jakkra/Agilent-6626A-GUI/PCB/cad_models/CT3151SP-6.igs

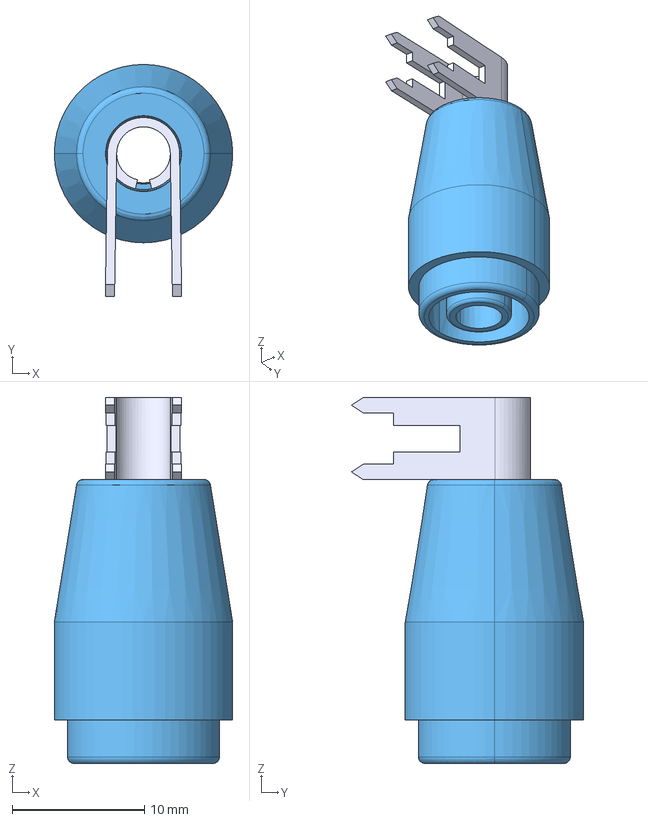
[picture p7: CAD file, 2024-12-04]
PCB/cad_models/CT3151SP-6.igs
13.5 x 17.6 x 27.7 mm
