jakkra/Agilent-6626A-GUI/PCB/cad_models/Same_Sky_UJ2-AH-4-TH.step

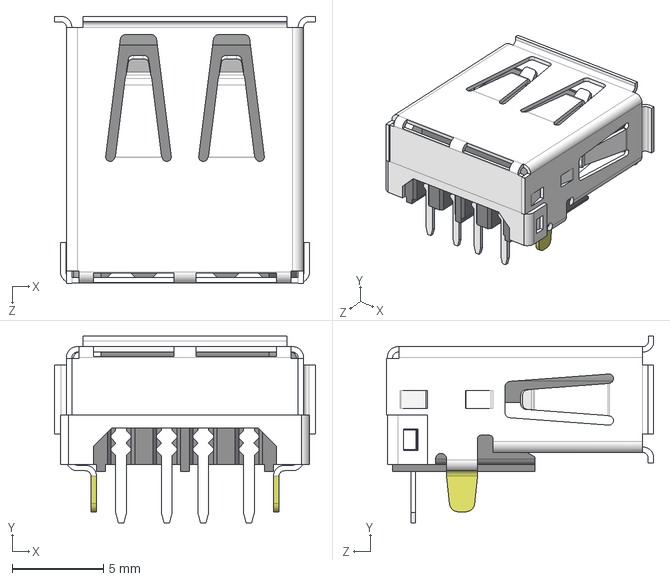
[picture p8: CAD file, 2024-12-04]
PCB/cad_models/Same_Sky_UJ2-AH-4-TH.step
14.3 x 10.2 x 14.7 mm
