jakkra/Agilent-6626A-GUI/PCB/cad_models/EG1213.stp

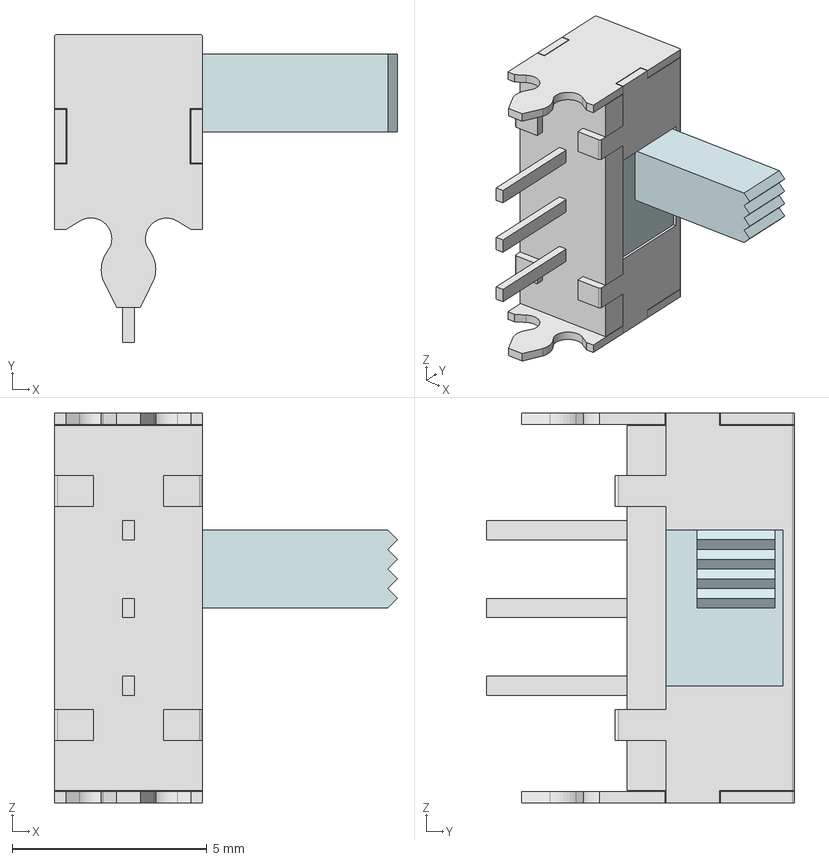
[picture p9: CAD file, 2024-12-04]
PCB/cad_models/EG1213.stp
8.80 x 7.90 x 10.0 mm
EG1213 SHELL
EG1213 TERM
EG1213 ACTUATOR
