jakkra/Agilent-6626A-GUI/PCB/cad_models/SOT-5X3-8.stp

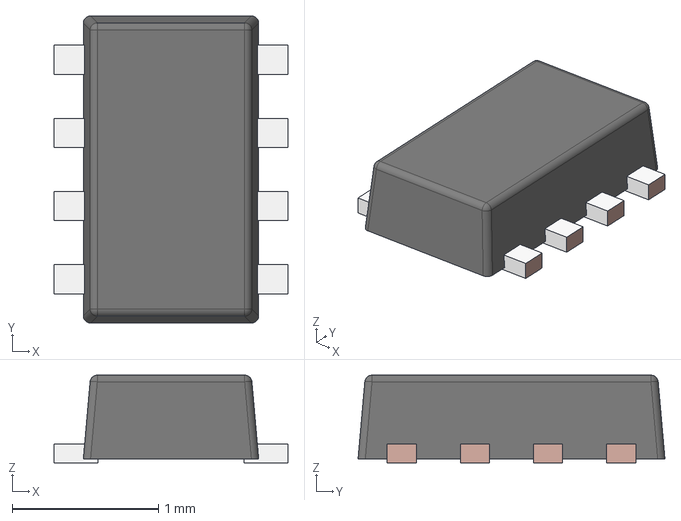
[picture p10: CAD file, 2024-12-04]
PCB/cad_models/SOT-5X3-8.stp
1.60 x 2.10 x 0.6 mm
FRAME-DRL0008A
BODY-SOT
