jakkra/Agilent-6626A-GUI/PCB/cad_models/SOT-323-5.stp

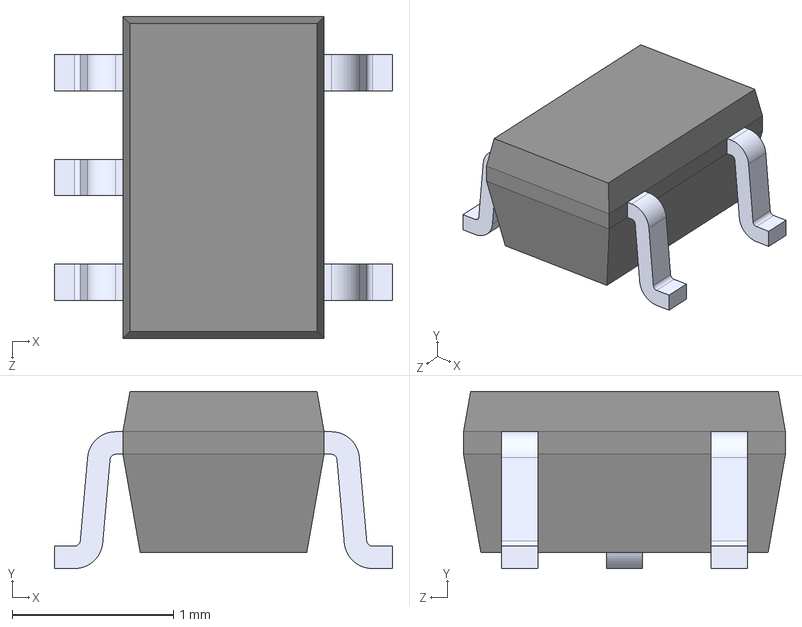
[picture p11: CAD file, 2024-12-04]
PCB/cad_models/SOT-323-5.stp
2.10 x 1.10 x 2.00 mm
