jakkra/Agilent-6626A-GUI/PCB/cad_models/pxc_1935792_05_01_PT-2-5-4-5-0-H_3D.stp

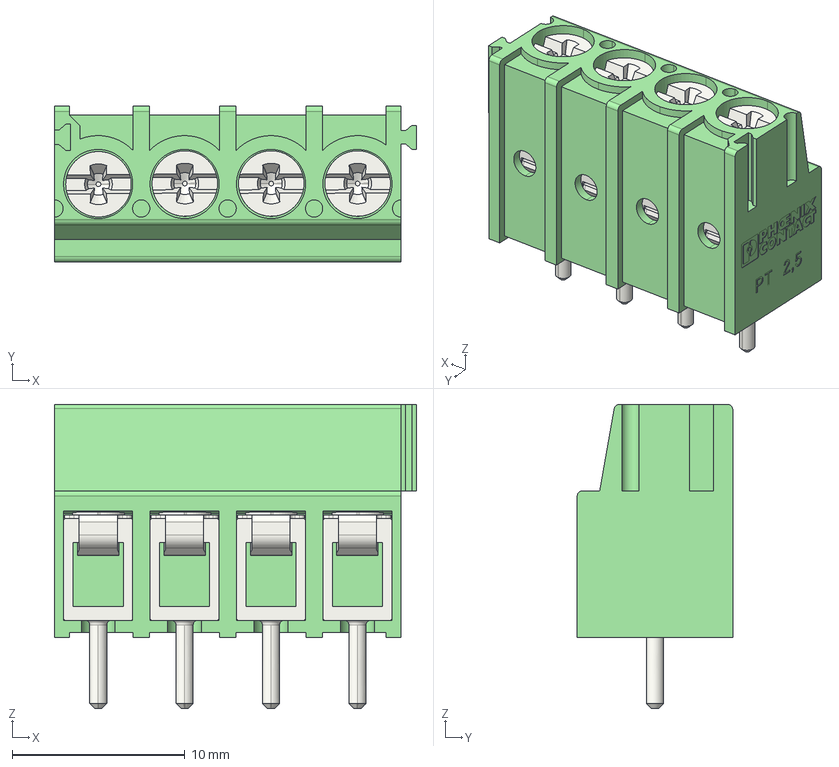
[picture p12: CAD file, 2024-12-04]
PCB/cad_models/pxc_1935792_05_01_PT-2-5-4-5-0-H_3D.stp
20.9 x 9.00 x 17.6 mm
