jakkra/Agilent-6626A-GUI/PCB/cad_models/DGS0010A.stp

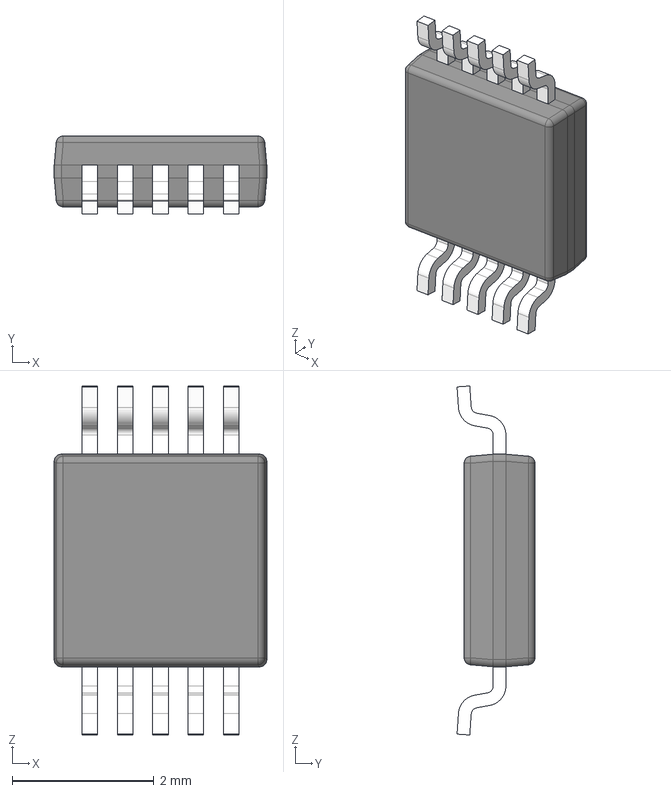
[picture p13: CAD file, 2024-12-04]
PCB/cad_models/DGS0010A.stp
3.00 x 1.10 x 4.93 mm
BODY-SO
LEAD-SO x 10
PIN1-ID
