jakkra/Agilent-6626A-GUI/(list of files, cad)

Other CAD files:
PCB/cad_models/CT3151SP-0.igs
PCB/cad_models/CT3151SP-2.igs
