jakkra/Agilent-6626A-GUI/PCB/power_supply_front.kicad_pcb

## KiCad design PCB/power_supply_front.kicad_pcb (2025-02-10)

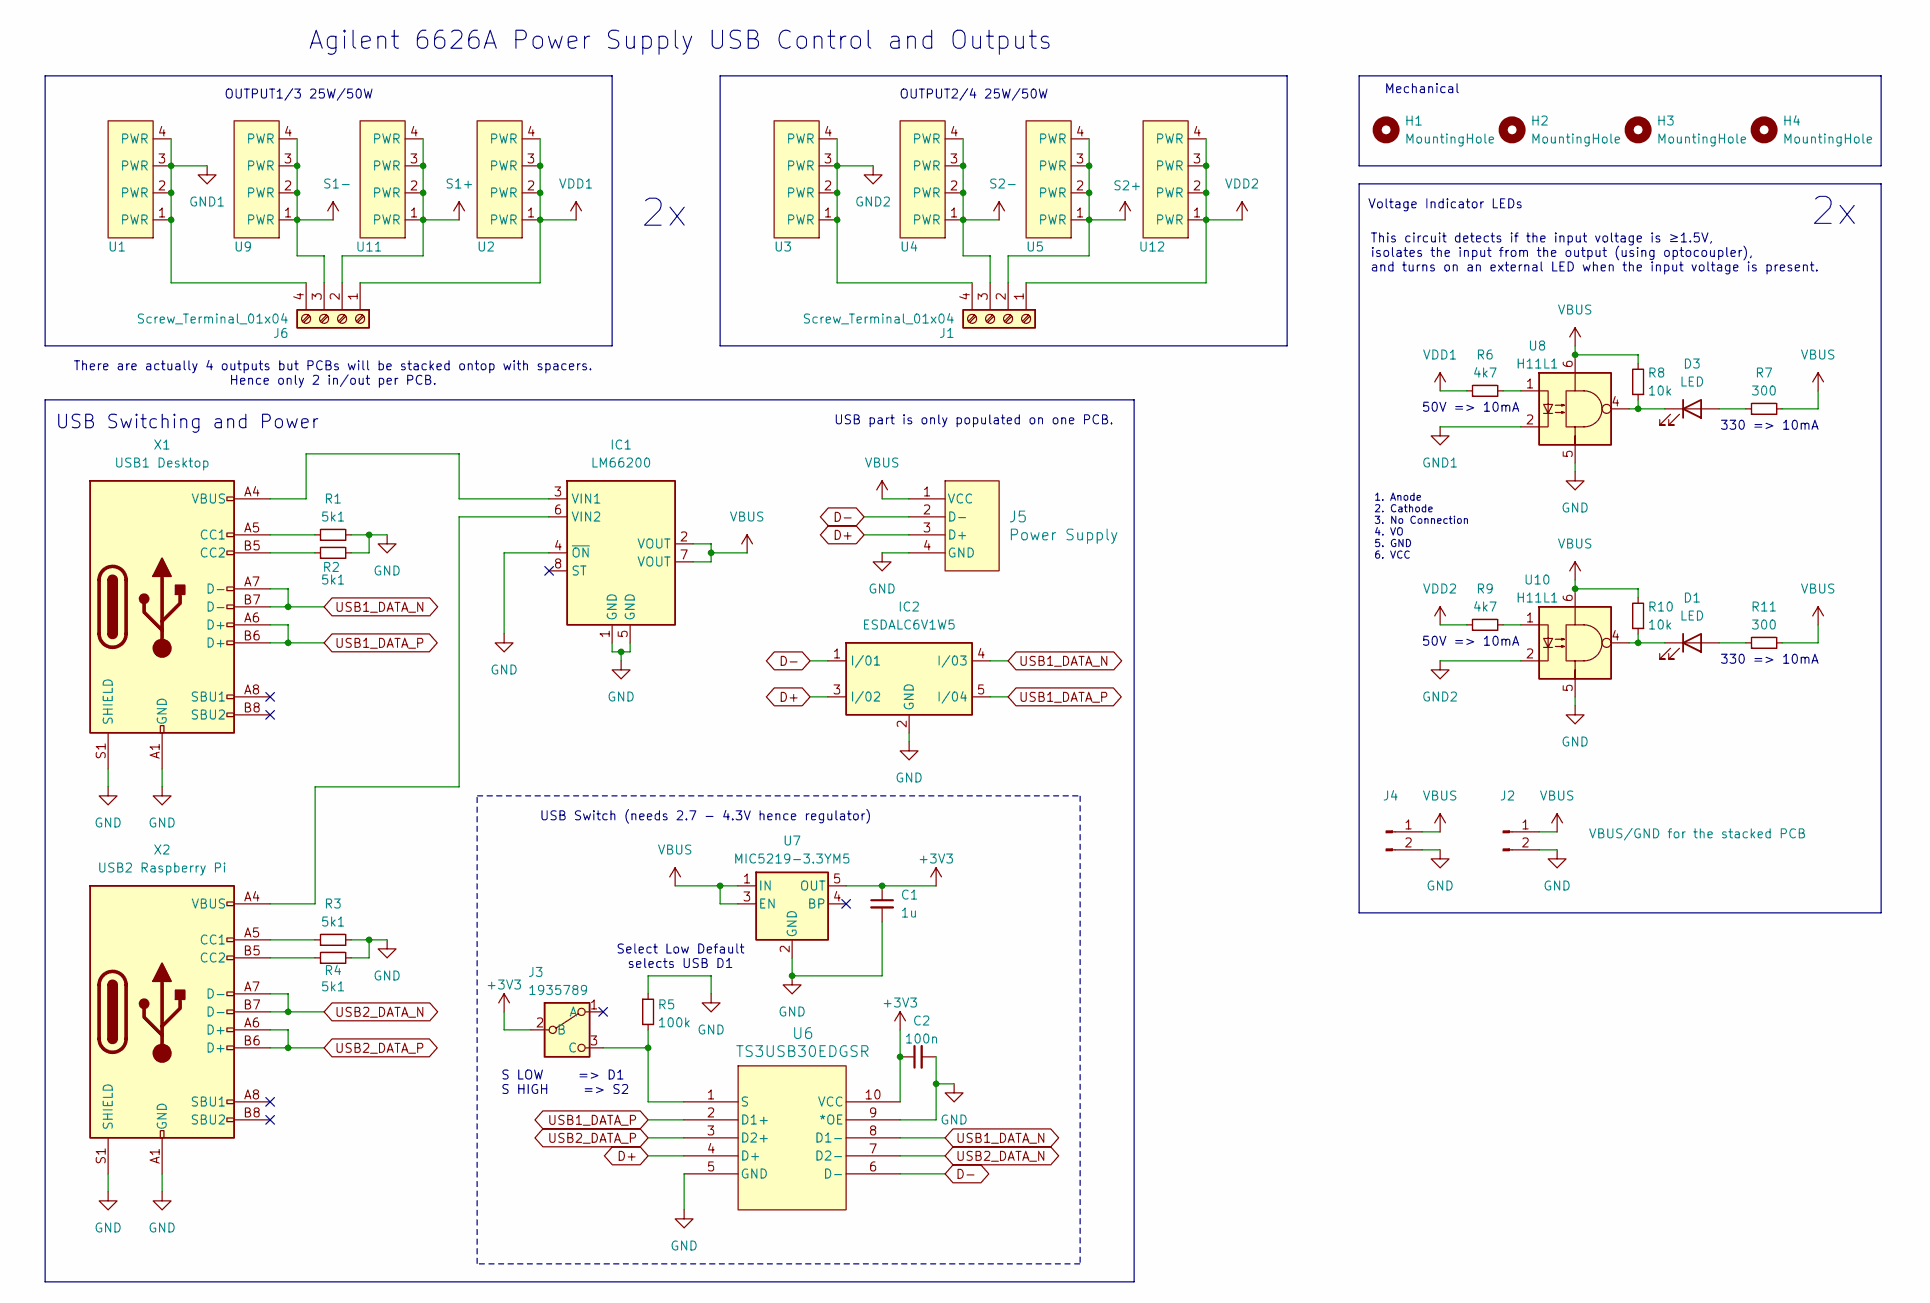
[picture p14: schematic power_supply_front.kicad_sch]

Parts:
C1: 1u; C_0603_1608Metric
C2: 100n; C_0603_1608Metric
D1, D3: LED; LED_D5.0mm
H1, H2, H3, H4: MountingHole; MountingHole_4mm_Pad_TopBottom
IC1: LM66200; SOT-5X3-8
IC2: ESDALC6V1W5; SOT-325-5
J1, J6: Screw_Terminal_01x04; PHOENIX_1935789
J2, J4: VBUS/GND for the stacked PCB; PinSocket_1x02_P2.54mm_Vertical
J3: 1935789; EG1213
J5: Power Supply; CONN4_UJ2-AH_CUD
R1, R2, R3, R4: 5k1; R_0603_1608Metric
R5: 100k; R_0603_1608Metric
R6, R9: 4k7; R_0603_1608Metric
R7, R11: 300; R_0603_1608Metric
R8, R10: 10k; R_0603_1608Metric
U1, U2, U3, U4, U5, U9, U11, U12: CT3151SP
U6: TS3USB30EDGSR; DGS10
U7: MIC5219-3.3YM5; SOT-23-5
U8, U10: H11L1; DIP-6_W10.16mm
X1: USB1 Desktop; USB_C_Receptacle_GCT_USB4105-xx-A_16P_TopMnt_Horizontal
X2: USB2 Raspberry Pi; USB_C_Receptacle_GCT_USB4105-xx-A_16P_TopMnt_Horizontal

Connections:
+3V3: C1.1, C2.1, J3.2 (B), U6.10 (VCC), U7.5 (OUT)
D+: IC2.3 (I/02), J5.3 (D+), U6.4 (D+)
D-: IC2.1 (I/01), J5.2 (D-), U6.6 (D-)
GND: C1.2, C2.2, IC1.1 (GND), IC1.4 (~ON), IC1.5 (GND), IC2.2 (GND), J2.2, J4.2, J5.4 (GND), R1.2, R2.2, R3.2, R4.2, R5.1, U6.5 (GND), U6.9 (*OE), U7.2 (GND), U8.5, U10.5, X1.A1 (GND), X1.A12 (GND), X1.B1 (GND), X1.B12 (GND), X1.S1 (SHIELD), X2.A1 (GND), X2.A12 (GND), X2.B1 (GND), X2.B12 (GND), X2.S1 (SHIELD)
GND1: J6.4, U1.1 (PWR), U1.2 (PWR), U1.3 (PWR), U1.4 (PWR), U8.2
GND2: J1.4, U3.1 (PWR), U3.2 (PWR), U3.3 (PWR), U3.4 (PWR), U10.2
unnamed: D1.2 (A), R11.1
unnamed: D1.1 (K), R10.1, U10.4
unnamed: D3.2 (A), R7.1
unnamed: D3.1 (K), R8.1, U8.4
unnamed: IC1.3 (VIN1), X1.A4 (VBUS), X1.A9 (VBUS), X1.B4 (VBUS), X1.B9 (VBUS)
unnamed: IC1.6 (VIN2), X2.A4 (VBUS), X2.A9 (VBUS), X2.B4 (VBUS), X2.B9 (VBUS)
unnamed: J3.3 (C), R5.2, U6.1 (S)
unnamed: R6.2, U8.1
unnamed: R9.2, U10.1
unnamed: R1.1, X1.A5 (CC1)
unnamed: R2.1, X1.B5 (CC2)
unnamed: R3.1, X2.A5 (CC1)
unnamed: R4.1, X2.B5 (CC2)
S1+: J6.2, U11.1 (PWR), U11.2 (PWR), U11.3 (PWR), U11.4 (PWR)
S1-: J6.3, U9.1 (PWR), U9.2 (PWR), U9.3 (PWR), U9.4 (PWR)
S2+: J1.2, U5.1 (PWR), U5.2 (PWR), U5.3 (PWR), U5.4 (PWR)
S2-: J1.3, U4.1 (PWR), U4.2 (PWR), U4.3 (PWR), U4.4 (PWR)
USB1_DATA_N: IC2.4 (I/03), U6.8 (D1-), X1.A7 (D-), X1.B7 (D-)
USB1_DATA_P: IC2.5 (I/04), U6.2 (D1+), X1.A6 (D+), X1.B6 (D+)
USB2_DATA_N: U6.7 (D2-), X2.A7 (D-), X2.B7 (D-)
USB2_DATA_P: U6.3 (D2+), X2.A6 (D+), X2.B6 (D+)
VBUS: IC1.2 (VOUT), IC1.7 (VOUT), J2.1, J4.1, J5.1 (VCC), R7.2, R8.2, R10.2, R11.2, U7.1 (IN), U7.3 (EN), U8.6, U10.6
VDD1: J6.1, R6.1, U2.1 (PWR), U2.2 (PWR), U2.3 (PWR), U2.4 (PWR)
VDD2: J1.1, R9.1, U12.1 (PWR), U12.2 (PWR), U12.3 (PWR), U12.4 (PWR)

Notes on the sheet:
Agilent 6626A Power Supply USB Control and Outputs
50V => 10mA
Mechanical
There are actually 4 outputs but PCBs will be stacked ontop with spacers. Hence only 2 in/out per PCB.
USB Switch (needs 2.7 - 4.3V hence regulator)
USB part is only populated on one PCB.
Select Low Default selects USB D1
This circuit detects if the input voltage is ≥1.5V, isolates the input from the output (using optocoupler), and turns on an external LED when the input voltage is present.
S LOW => D1 S HIGH => S2
OUTPUT1/3 25W/50W
Voltage Indicator LEDs
1. Anode 2. Cathode 3. No Connection 4. VO 5. GND 6. VCC
330 => 10mA
USB Switching and Power
OUTPUT2/4 25W/50W

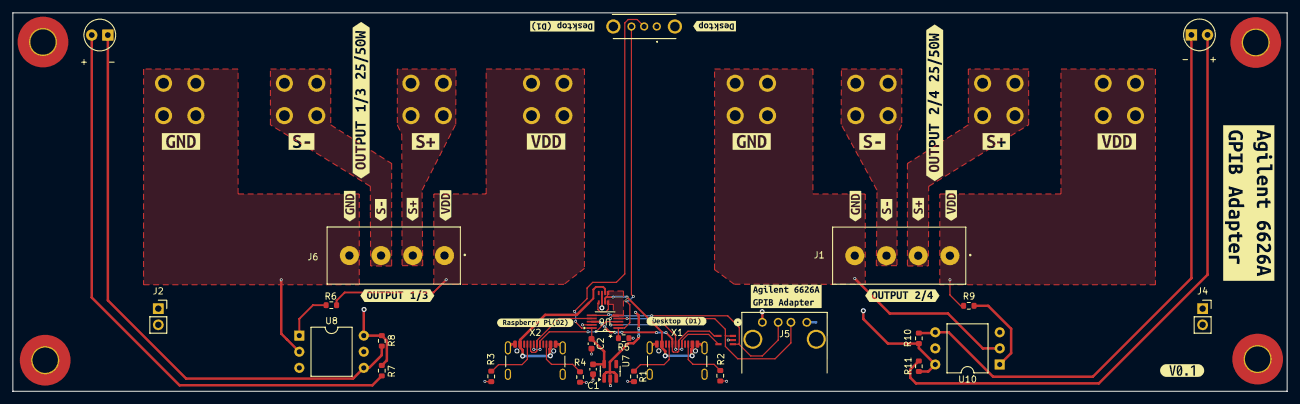
[picture p15: board power_supply_front.kicad_pcb from above]

Board: 2 copper layers, 200.9 x 59.7 mm, 69 parts (1 on the bottom side), 30 nets.

Other parts of the board:
kibuzzard-674E1A25: G***; kibuzzard-674E1A25
kibuzzard-674E1A52: G***; kibuzzard-674E1A52
kibuzzard-674E1B6F: G***; kibuzzard-674E1B6F
kibuzzard-674E1B37: G***; kibuzzard-674E1B37
kibuzzard-674E1B67: G***; kibuzzard-674E1B67
kibuzzard-674E1BAB: G***; kibuzzard-674E1BAB
kibuzzard-674E1BF2: G***; kibuzzard-674E1BF2
kibuzzard-674F779A: G***; kibuzzard-674F779A
kibuzzard-674F7791: G***; kibuzzard-674F7791
kibuzzard-6759F0B5: G***; kibuzzard-6759F0B5
kibuzzard-67536A0A, kibuzzard-67536A0A#2: G***; kibuzzard-67536A0A
kibuzzard-67536AC1: G***; kibuzzard-67536AC1
kibuzzard-67536BD6: G***; kibuzzard-67536BD6
kibuzzard-675368B8, kibuzzard-675368B8#2: G***; kibuzzard-675368B8
kibuzzard-675368D0, kibuzzard-675368D0#2: G***; kibuzzard-675368D0
kibuzzard-675368D9, kibuzzard-675368D9#2: G***; kibuzzard-675368D9
kibuzzard-675368DE, kibuzzard-675368DE#2: G***; kibuzzard-675368DE
kibuzzard-675369A2, kibuzzard-675369A2#2: G***; kibuzzard-675369A2
kibuzzard-675369E9, kibuzzard-675369E9#2: G***; kibuzzard-675369E9
kibuzzard-675369FB, kibuzzard-675369FB#2: G***; kibuzzard-675369FB
