jakkra/Agilent-6626A-GUI/power_supply.py

import random
import pyvisa
import time
import threading


class PowerSupplyError(Exception):
    """Custom exception for power supply errors."""

    pass


class PowerSupplyChannelNotEnabledError(PowerSupplyError):
    """Custom exception for power supply when channel is not enabled."""

    pass


class PowerSupplyTimeoutError(PowerSupplyError):
    """Custom exception for power supply when a timeout occurs."""

    pass


class PowerSupply:
    def __init__(self, debug=False, mock=False):
        # Initialize the power supply
        self.channels = {
            1: False,
            2: False,
            3: False,
            4: False,
        }  # Example state tracking
        self.set_voltages = {
            1: 0.0,
            2: 0.0,
            3: 0.0,
            4: 0.0,
        }
        self.set_currents = {
            1: 0.0,
            2: 0.0,
            3: 0.0,
            4: 0.0,
        }
        self.lock = threading.RLock()
        self.connection = False
        self.debug = debug
        self.mock = mock
        self.rm = pyvisa.ResourceManager()

    def _send_command(self, command):
        """
        Prepends the module prefix to all commands and sends them.
        :param command: The SCPI command to send (without the module prefix).
        """
        with self.lock:
            full_command = f"OUTPUT {self.module_id}; {command}"
            if self.debug:
                print(f"Sending command: {full_command}")
            if not self.mock:
                self.instrument.write(full_command)
            time.sleep(0.2)

    def _query_command(self, command):
        """
        Prepends the module prefix to a query command and sends it.
        :param command: The SCPI query to send (without the module prefix).
        :return: The response from the instrument.
        """
        with self.lock:
            try:
                full_command = f"OUTPUT {self.module_id}; {command}"
                if self.debug:
                    print(f"Sending query: {full_command}")
                if not self.mock:
                    res = self.instrument.query(full_command)
                    if self.debug:
                        print(f"Received response: {res}")
                    return res
            except pyvisa.errors.VisaIOError as e:
                print(f"VisaIOError: {e}")
                raise PowerSupplyTimeoutError(
                    "Timeout occurred while communicating with power supply."
                )
            except Exception as e:
                raise PowerSupplyError("Failed to communicate with power supply.")

    def _init_instrument(self):
        """
        Initializes the power supply instrument.
        """
        self._send_command("CLR")
        self._send_command("DSP 1")  # Turn on display

    def list_resources(self):
        """
        List available resources.

        Returns:
        list: A list of available resources
        """
        return self.rm.list_resources()

    def connect(self, serial_port, baudrate, instrument_id, timeout=2500):
        """
        Connect to the power supply.

        Parameters:
        serial_port (str): The serial port to use (e.g., 'COM3', '/dev/ttyUSB0')
        baudrate (int): The baud rate for the serial communication
        instrument_id (str): The instrument ID to identify the power supply
        param timeout (int): Timeout for communication in milliseconds (default: 5000)

        Raises:
        PowerSupplyError: If connection fails.
        """
        if not serial_port or not baudrate or not instrument_id:
            raise PowerSupplyError("Invalid connection parameters.")

        self.module_id = instrument_id
        if not self.mock:
            self.instrument = self.rm.open_resource(serial_port)
            self.instrument.baud_rate = baudrate
            self.instrument.timeout = timeout
            self.instrument.read_termination = "\r"
        self.connection = True
        # TODO handle error
        self.send_raw_command("++auto 1")
        time.sleep(0.1)
        self.send_raw_command("++addr 5")
        time.sleep(0.1)
        self.send_raw_command("++eot_char 13")
        time.sleep(0.1)
        self.send_raw_command("++eot_enable 1")
        time.sleep(1)
        print(f"Connected to: {self._query_command(f'ID?')}")
        attempts = 0
        while attempts < 3:
            try:
                response = self._query_command(f"ID?")
                print(f"Connected to: {response}")
                break
            except Exception as e:
                attempts += 1
                print(f"Attempt {attempts} failed: {e}")
                if attempts >= 3:
                    raise PowerSupplyError(
                        "Failed to connect to power supply after 3 attempts."
                    )
        print(
            f"Connected to power supply on {serial_port} with baudrate {baudrate} and instrument ID {instrument_id}"
        )

    def write_to_screen(self, text):
        """
        Write text to the power supply screen.
        :param text: The text to write to the screen. Max 12 capital letters.  Only upper case alpha characters, numbers, and spaces will be displayed.
        """
        if len(text) > 12:
            raise PowerSupplyError("Text must be less than 12 characters")
        text = text.upper()
        self._send_command(f'DSP "{text}"')

    def disconnect(self):
        """
        Disconnect from the power supply.

        Raises:
        PowerSupplyError: If disconnection fails.
        """
        with self.lock:
            if not self.connection:
                raise PowerSupplyError("Failed to disconnect from power supply.")
            self.instrument.close()
            self.connection = False
            print("Disconnected from power supply")

    def set_voltage(self, channel, voltage):
        """
        Set the voltage for a specific channel.

        Parameters:
        channel (int): The channel number (e.g., 1, 2, 3, 4)
        voltage (float): The voltage to set

        Raises:
        PowerSupplyError: If the channel is not turned on or communication fails.
        """
        with self.lock:
            if not self.connection:
                raise PowerSupplyError("Power supply is not connected.")
            if voltage < 0:
                raise PowerSupplyError("Failed to communicate with power supply.")
            print(f"Setting voltage of channel {channel} to {voltage}V")
            self._send_command(f"VSET {channel},{voltage}")
            self.set_voltages[channel] = voltage

    def set_current_limit(self, channel, current):
        """
        Set the current for a specific channel.

        Parameters:
        channel (int): The channel number (e.g., 1, 2, 3, 4)
        current (float): The current to set

        Raises:
        PowerSupplyError: If the channel is not turned on or communication fails.
        """
        with self.lock:
            if not self.connection:
                raise PowerSupplyError("Power supply is not connected.")
            if current < 0:
                raise PowerSupplyError("Failed to communicate with power supply.")
            print(f"Setting current limit of channel {channel} to {current}A")
            self._send_command(f"ISET {channel},{current}")
            self.set_currents[channel] = current

    def set_voltage_range(self, channel, voltage_range):
        """
        Sets the voltage programming resolution range for the specified channel and voltage.
        The power supply will automatically pick the range that the value sent will fit into.
        :param channel: Output channel number
        :param voltage_range: Voltage
        """
        with self.lock:
            self._send_command(f"VRSET {channel},{voltage_range}")

    def set_current_range(self, channel, current_range):
        """
        Sets the current programming resolution range for the specified channel and current.
        The power supply will automatically pick the range that the value sent will fit into.
        :param channel: Output channel number
        :param current_range: Current Amperes
        """
        with self.lock:
            self._send_command(f"IRSET {channel},{current_range}")

    def enable_output(self, channel):
        """
        Turn on a specific channel.

        Parameters:
        channel (int): The channel number (e.g., 1, 2, 3, 4)

        Raises:
        PowerSupplyError: If communication fails.
        """
        with self.lock:
            if not self.connection:
                raise PowerSupplyError("Power supply is not connected.")
            if channel not in self.channels:
                raise PowerSupplyError("Failed to communicate with power supply.")
            self.channels[channel] = True
            print(f"Turning on channel {channel}")
            self._send_command(f"OUT {channel},1")

    def disable_output(self, channel):
        """
        Turn off a specific channel.

        Parameters:
        channel (int): The channel number (e.g., 1, 2, 3, 4)

        Raises:
        PowerSupplyError: If communication fails.
        """
        with self.lock:
            if not self.connection:
                raise PowerSupplyError("Power supply is not connected.")
            if channel not in self.channels:
                raise PowerSupplyError("Failed to communicate with power supply.")
            self.channels[channel] = False
            print(f"Turning off channel {channel}")
            self._send_command(f"OUT {channel},0")

    def set_overvoltage_protection(self, channel, voltage):
        """
        Configures the overvoltage protection trip point for the specified channel.
        :param channel: Output channel number
        :param voltage: OVP trip point in volts
        """
        with self.lock:
            self._send_command(f"OVSET {channel},{voltage}")

    def enable_overcurrent_protection(self, channel):
        """
        Enables the overcurrent protection for the specified channel.
        :param channel: Output channel number
        """
        with self.lock:
            self._send_command(f"OCP {channel},ON")

    def disable_overcurrent_protection(self, channel):
        """
        Disables the overcurrent protection for the specified channel.
        :param channel: Output channel number
        """
        with self.lock:
            self._send_command(f"OCP {channel},OFF")

    def get_output_voltage(self, channel):
        """
        Queries the output voltage of the specified channel.
        :param channel: Output channel number
        :return: Measured output voltage in volts
        """
        with self.lock:
            if not self.connection:
                raise PowerSupplyError("Power supply is not connected.")
            if channel not in self.channels:
                raise PowerSupplyError("Failed to communicate with power supply.")
            if not self.channels.get(channel, False):
                raise PowerSupplyError(f"Channel {channel} is not turned on.")
            if self.mock:
                return (
                    self.get_programmed_voltage(channel) + (random.random() - 0.5) * 0.1
                )
            result = float(self._query_command(f"VOUT? {channel}"))
            if result < 0:
                result = 0.0
            return result

    def get_output_current(self, channel):
        """
        Queries the output current of the specified channel.
        :param channel: Output channel number
        :return: Measured output current in amperes
        """
        with self.lock:
            if not self.connection:
                raise PowerSupplyError("Power supply is not connected.")
            if channel not in self.channels:
                raise PowerSupplyError("Failed to communicate with power supply.")
            if not self.channels.get(channel, False):
                raise PowerSupplyChannelNotEnabledError(
                    f"Channel {channel} is not turned on."
                )
            if self.mock:
                return (
                    self.get_programmed_current_limit(channel)
                    + (random.random() - 0.5) * 0.1
                )
            return float(self._query_command(f"IOUT? {channel}"))

    def get_programmed_voltage(self, channel):
        """
        Queries the programmed voltage for the specified channel.
        :param channel: Output channel number
        :return: Programmed voltage in volts
        """
        with self.lock:
            if self.mock:
                return self.set_voltages[channel]

            result = float(self._query_command(f"VSET? {channel}"))
            if result < 0:
                result = 0.0
            return result

    def get_programmed_current_limit(self, channel):
        """
        Queries the programmed current limit for the specified channel.
        :param channel: Output channel number
        :return: Programmed current limit in amperes
        """
        with self.lock:
            if self.mock:
                return self.set_currents[channel]
            result = float(self._query_command(f"ISET? {channel}"))
            if result < 0:
                result = 0.0
            return result

    def send_raw_command(self, command):
        """
        Send a command to the power supply and return the response.

        Parameters:
        command (str): The command to send

        Raises:
        PowerSupplyError: If communication fails.

        Returns:
        str: The response from the power supply
        """
        with self.lock:
            if not self.connection:
                raise PowerSupplyError("Power supply is not connected.")
            if not command:
                raise PowerSupplyError("Command is empty.")

            # Simulate sending command and receiving response
            if self.debug:
                print(f"Sending command: {command}")
            self.instrument.write(command)
            # response = "OK"  # Simulated response
            # print(f"Received response: {response}")
            return "TODO: Implement response"

    def get_num_enabled_channels(self):
        """
        Get the number of enabled channels.
        :return: The number of enabled channels
        """
        with self.lock:
            print("Number of enabled channels: ", sum(self.channels.values()))
            return sum(self.channels.values())

    def is_channel_enabled(self, channel):
        """
        Check if a channel is enabled.
        :param channel: Channel number
        :return: True if channel is enabled, False otherwise
        """
        with self.lock:
            return self.channels.get(channel, False)
