jakkra/Agilent-6626A-GUI/(commit log)

2024-11-24 Initial power supply GUI.
2024-11-25 Implement API for the power supply commands (not tested).
2024-11-25 Reset supply on connect. Add ability to set text to supply screen.
    [power_supply.py]
2024-11-26 Add mock and debug option to Power Supply API.
2024-11-26 Fetch actual volage and current consumed when a output is on.
2024-11-26 Add plotting in new window for the actual output current.
2024-12-04 PCB: Add KiCad project for the output and control interface.
    [CT3151SP-0.igs, CT3151SP-2.igs, CT3151SP-6.igs, DGS0010A.stp, EG1213.stp, SOT-323-5.stp, SOT-5X3-8.stp, Same_Sky_UJ2-AH-4-TH.step]
2024-12-06 Adjust plug spacing. Add label connector pinout on silkscreen.
    [power_supply_front.kicad_pcb, power_supply_front.kicad_sch]
2024-12-08 UI: Tested on real HW, fixes needed for that.
    [main.py, plot_window.py, power_supply.py]
2025-02-10 PCB: Small adjustments.
    [power_supply_front.kicad_pcb]
2025-02-12 CAD: Add the enclosure design.
2025-08-28 UI: Improve setting voltage/current on small screen by using a modal popup.
2025-08-28 UI: Add automatic display power management to turn off the display after a period of inactivity.
    Turns off screen and backlight after 5 minutes.
    Touch the screen to quickly wake it up.
